jrthomas/closet-freecool/hardware/PCB-BOM.pdf

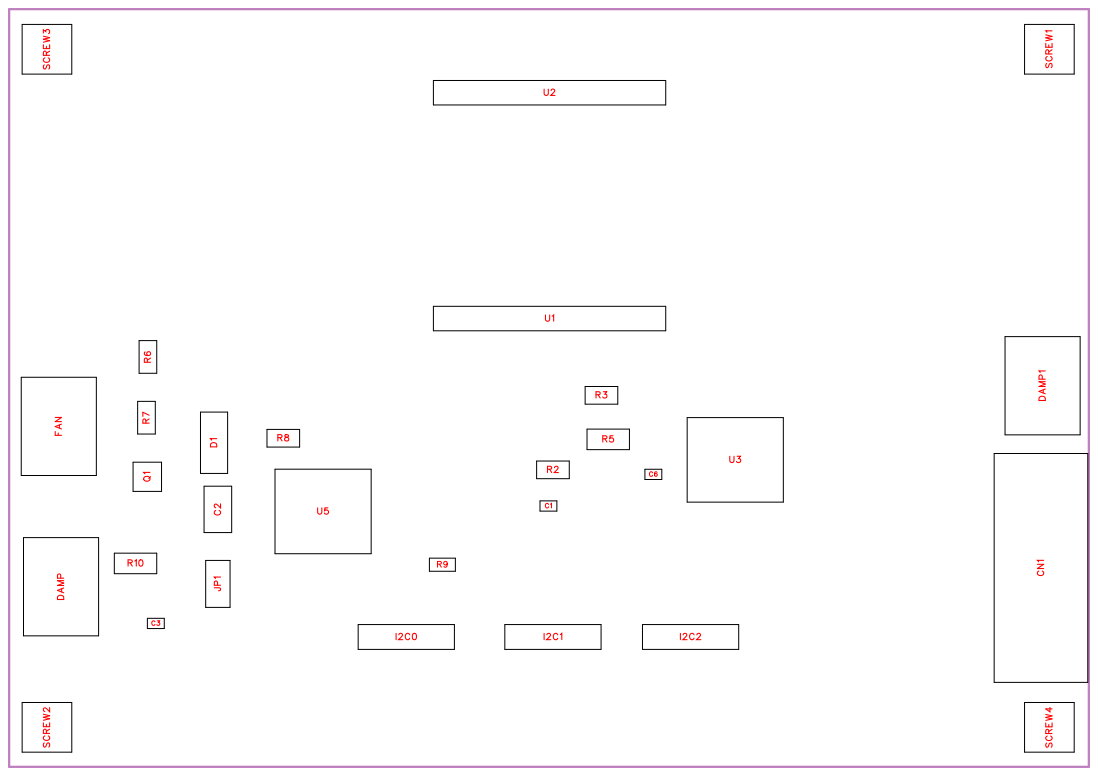
[picture p6: page 1]

No. | Quantity | Comment | Designator | Footprint | Value | Manufacturer Part | Manufacturer | Supplier Part | Supplier
1 | 3 | 100nF | C1,C3,C6 | C0402 | 100nF | CL05B104K O5NNNC | SAMSUNG( 三星) | C1525 | LCSC
2 | 1 | 4.7uF | C2 | CAP-SMD_L 3.5-W2.8 | 4.7uF | CA45A-B-35 V-4.7UF-K | XY(振华新云) | C2976928 | LCSC
3 | 1 | A5081WV-05 P | CN1 | CONN-TH_5 P-P5.08_L10 .2-W25.4 | | A5081WV-05 P | HR(灿达) | C476918 | LCSC
4 | 1 | SMAJ12CA XE | D1 | SMA_L4.3-W 2.7-LS5.1-BI | | SMAJ12CA XE | TDSEMIC(拓 电半导体) | C46956331 | LCSC
5 | 1 | DAMPER | DAMP | CONN-TH_2 P-P5.08 | | TB006-508-0 2BE | | C990002062 2 | LCSC
6 | 1 | DEHUM | DAMP1 | CONN-TH_2 P-P5.08 | | TB006-508-0 2BE | | C990002062 2 | LCSC
7 | 1 | GPIO 4 | FAN | CONN-TH_2 P-P5.08 | | TB006-508-0 2BE | | C990002062 2 | LCSC
8 | 3 | I2C | I2C0,I2C1,I2C2 | HDR-TH_4P-P2.54-V-F | | HC-08蓝牙 | | C990001677 8 | LCSC
9 | 1 | HEAD2 | JP1 | HDR-TH_2P-P2.54-V-M | | HEAD2 | | C990001003 0 | LCSC
10 | 1 | BSS138 | Q1 | SOT-23-3_L2 .9-W1.3-P1.9 0-LS2.4-BR-1 | | BSS138 | KUU | C3015220 | LCSC
11 | 1 | 4.7k | R2 | R0805 | 4.7k | 0805W8F470 1T5E | UNI-ROYAL( 厚声) | C17673 | LCSC
12 | 4 | 220 | R3,R6,R7,R8 | R0805 | 220 | 0805W8F220 0T5E | UNI-ROYAL( 厚声) | C17557 | LCSC
13 | 2 | 100 | R5,R10 | R1206 | 100 | 1206W4F100 0T5E | UNI-ROYAL( 厚声) | C17901 | LCSC
14 | 1 | 100k | R9 | R0603 | 100k | RC0603FR-0 7100KL | YAGEO(国巨 ) | C14675 | LCSC
15 | 4 | Screw-Hole-M3 | SCREW1,SCREW2,SCRE W3,SCREW4 | Screw-Hole-M3
16 | 2 | cn10_2r54_1 0x1 | U1,U2 | HDR-TH_10 P-P2.54-V-F | | cn10_2r54_1 0x1 | | C990000141 5 | LCSC
17 | 2 | AQH2223 | U3,U5 | DIP-8_7P-L9. 7-W6.4-P2.5 4-LS7.6-BL-P E7 | | AQH2223 | PANASONIC (松下) | C128520 | LCSC

## ETH

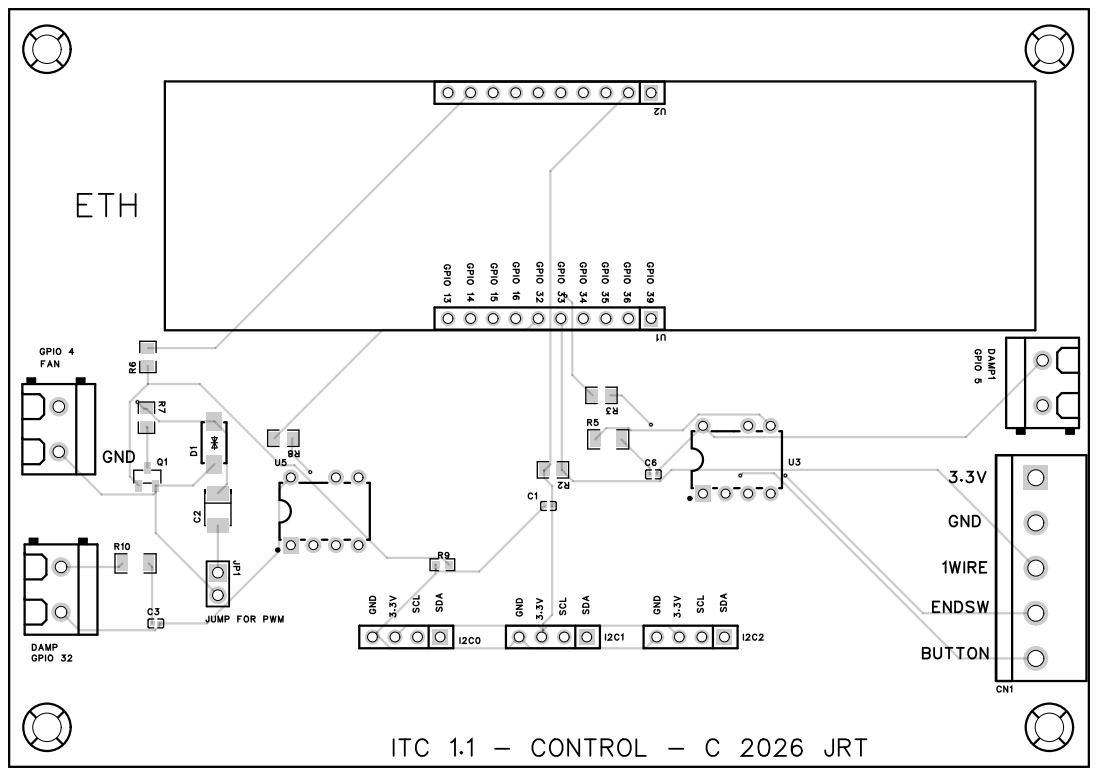
[picture p7: page 4]

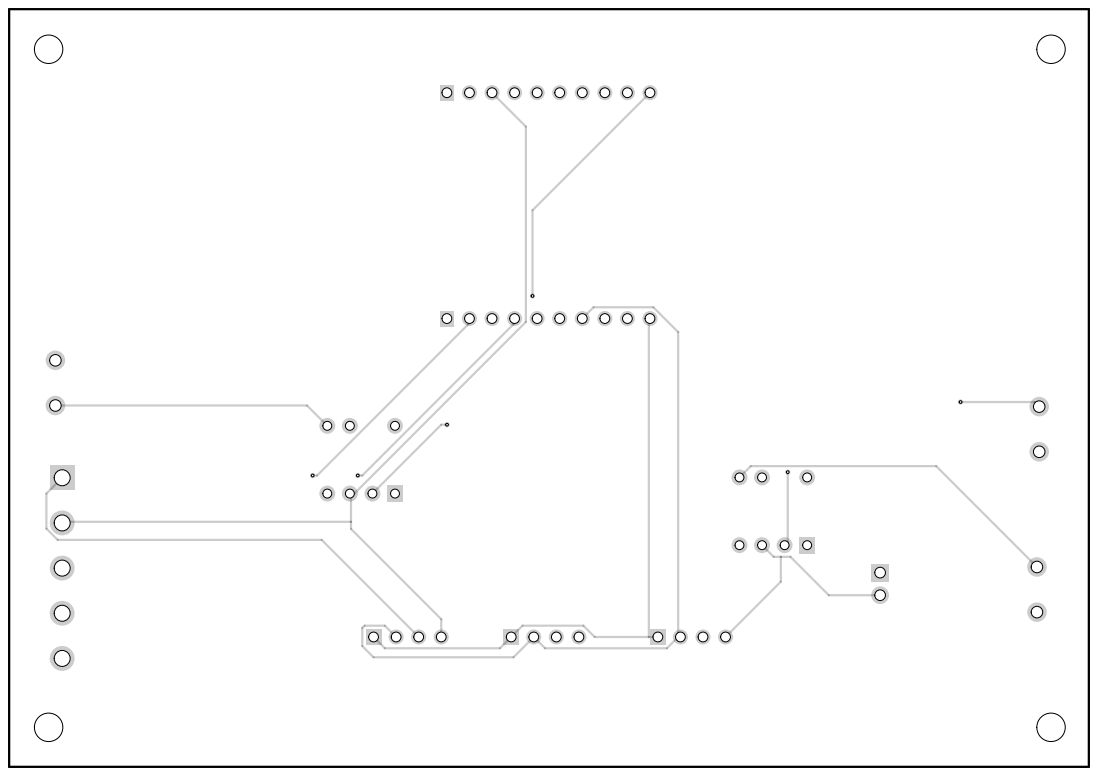
[picture p8: page 5]

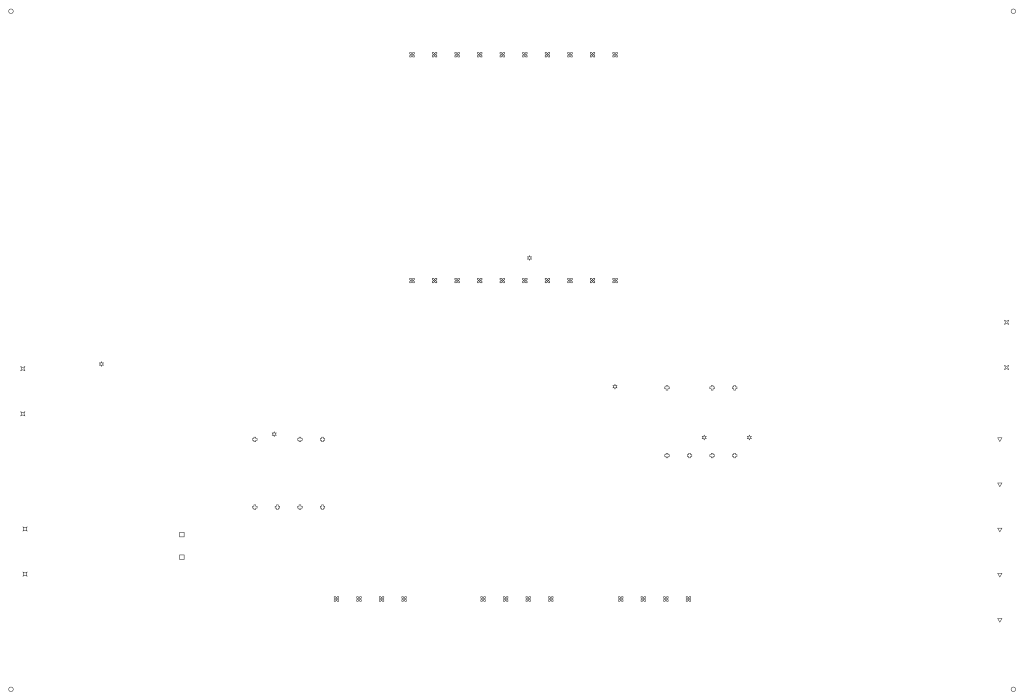
[picture p9: page 6]
