jrthomas/closet-freecool/hardware/Schematic.pdf

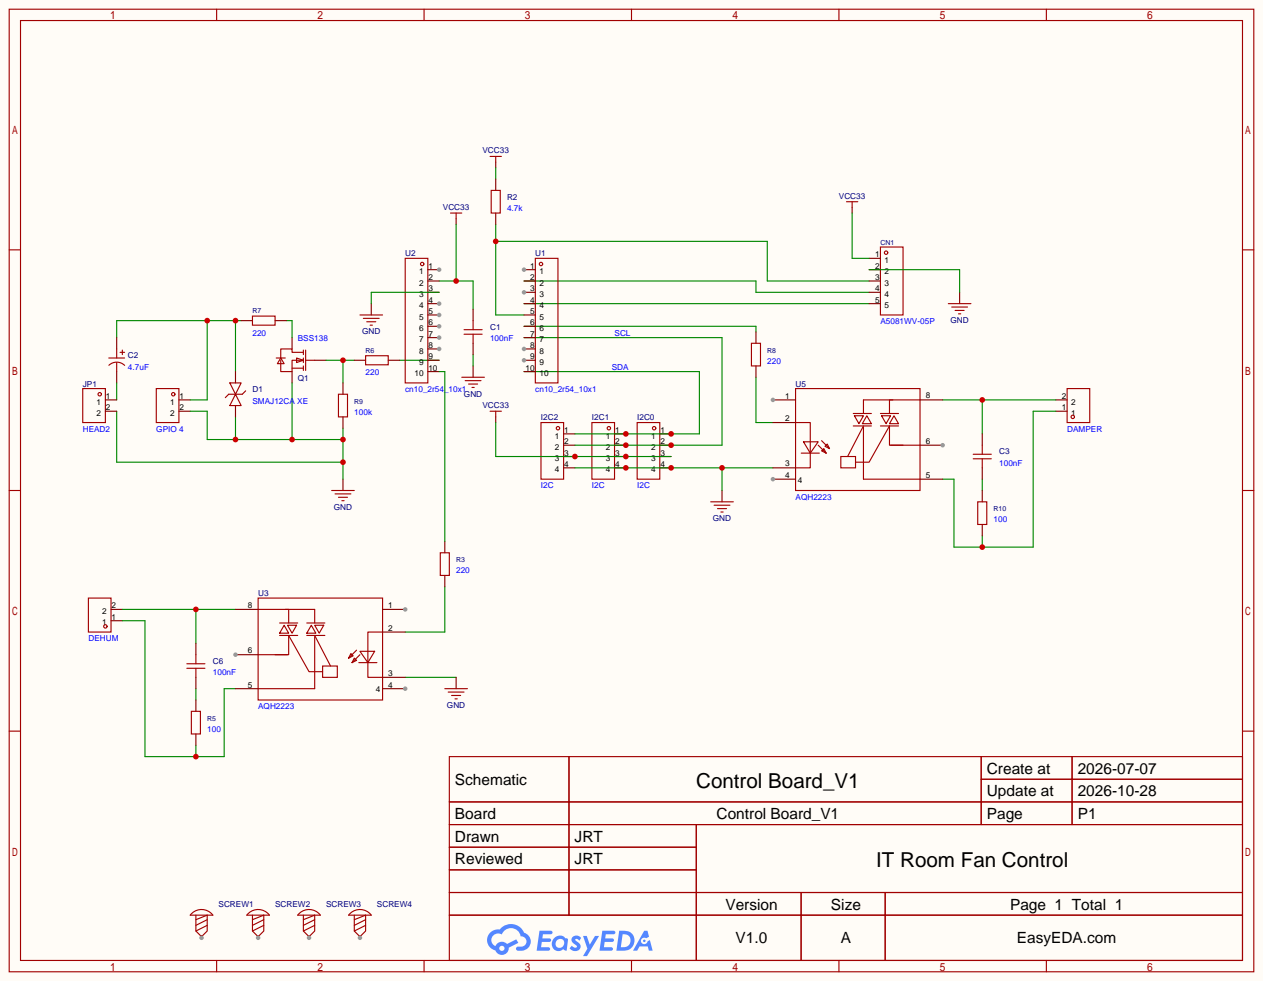
[picture p10: page 1]

Schematic | Control Board_V1 | Create at | 2026-07-07

Update at | 2026-10-28

Board | Control Board_V1 | Page | P1
Drawn | JRT | IT Room Fan Control
Reviewed | JRT

Version | Size | Page 1 Total 1
V1.0 | A | EasyEDA.com
